ciroque/portal-gun-firmware/adr/README.md

# Architecture decision records

ADRs capture a consequential decision, its reason, and its tradeoffs. Keep each
record short; implementation details belong in code or design documents.

These initial records capture decisions already stated in
[the project handoff](../THE-NEW-HOTNESS.md). They do not represent a completed
architecture proposal or hardware validation.

| ADR | Decision | Status |
| --- | --- | --- |
| [0001](0001-native-esp-idf.md) | Use ESP32-S3 with native ESP-IDF and C++ | Accepted |
| [0002](0002-preserve-existing-behavior.md) | Preserve the sketch's behavior during migration | Accepted |
| [0003](0003-controller-coordinates-subsystems.md) | Coordinate subsystems through a responsive controller | Accepted |
| [0004](0004-persist-settings-in-nvs.md) | Persist validated, versioned settings in NVS | Accepted |
| [0005](0005-removable-battery-and-hardware-power.md) | Use a removable battery and physical power disconnect | Accepted |
| [0006](0006-synchronized-lighting-and-muzzle.md) | Synchronize charge indicators and muzzle with firing phases | Accepted; muzzle portion superseded by 0009 |
| [0007](0007-native-audio-and-standalone-operation.md) | Prefer native audio and keep operation independent of networking | Accepted |
| [0008](0008-gpio-allocation.md) | Allocate GPIOs while preserving programming and debug interfaces | Accepted; board photos checked |
| [0009](0009-defer-muzzle-emitter.md) | Defer muzzle emitter; retain driver selection and deferral details | Accepted |
| [0010](0010-audio-hardware.md) | Use Adafruit #3006 with one Shutao 4 Ω / 3 W speaker | Accepted |
| [0011](0011-power-budget.md) | Budget initial-build power and validate the candidate supply | Proposed |
| [0012](0012-charge-led-timing.md) | Space charge LED transitions across the spin-up duration | Accepted |
| [0013](0013-settings-feedback.md) | Provide nonblocking curve and color feedback with trigger interruption | Accepted |
| [0014](0014-audio-events-and-failed-shots.md) | Map audio events and add a 5% cosmetic failed-shot outcome | Accepted |
| [0015](0015-audio-format-and-storage.md) | Embed mono 44.1 kHz 16-bit PCM WAV playback assets in firmware flash | Accepted |
| [0016](0016-firmware-component-architecture.md) | Separate portable effect logic from ESP-IDF adapters; use controller and audio tasks | Accepted baseline |
| [0017](0017-test-framework-and-tdd.md) | Use doctest for host TDD and Unity for target-specific checks | Accepted |

Use sequential numbers and descriptive filenames. New decisions can start as
**Proposed** and become **Accepted** when agreed. Preserve old records when a
decision changes: mark them **Superseded by ADR-NNNN** and link the replacement.

Still open: overall power budget validation and implementation/bench tuning
identified in ADR-0016. Component boundaries and layout are established there.
