ciroque/portal-gun-firmware/docs/kicad/audio/audio.kicad_sch

## KiCad design docs/kicad/audio/audio.kicad_sch (2026-10-30)

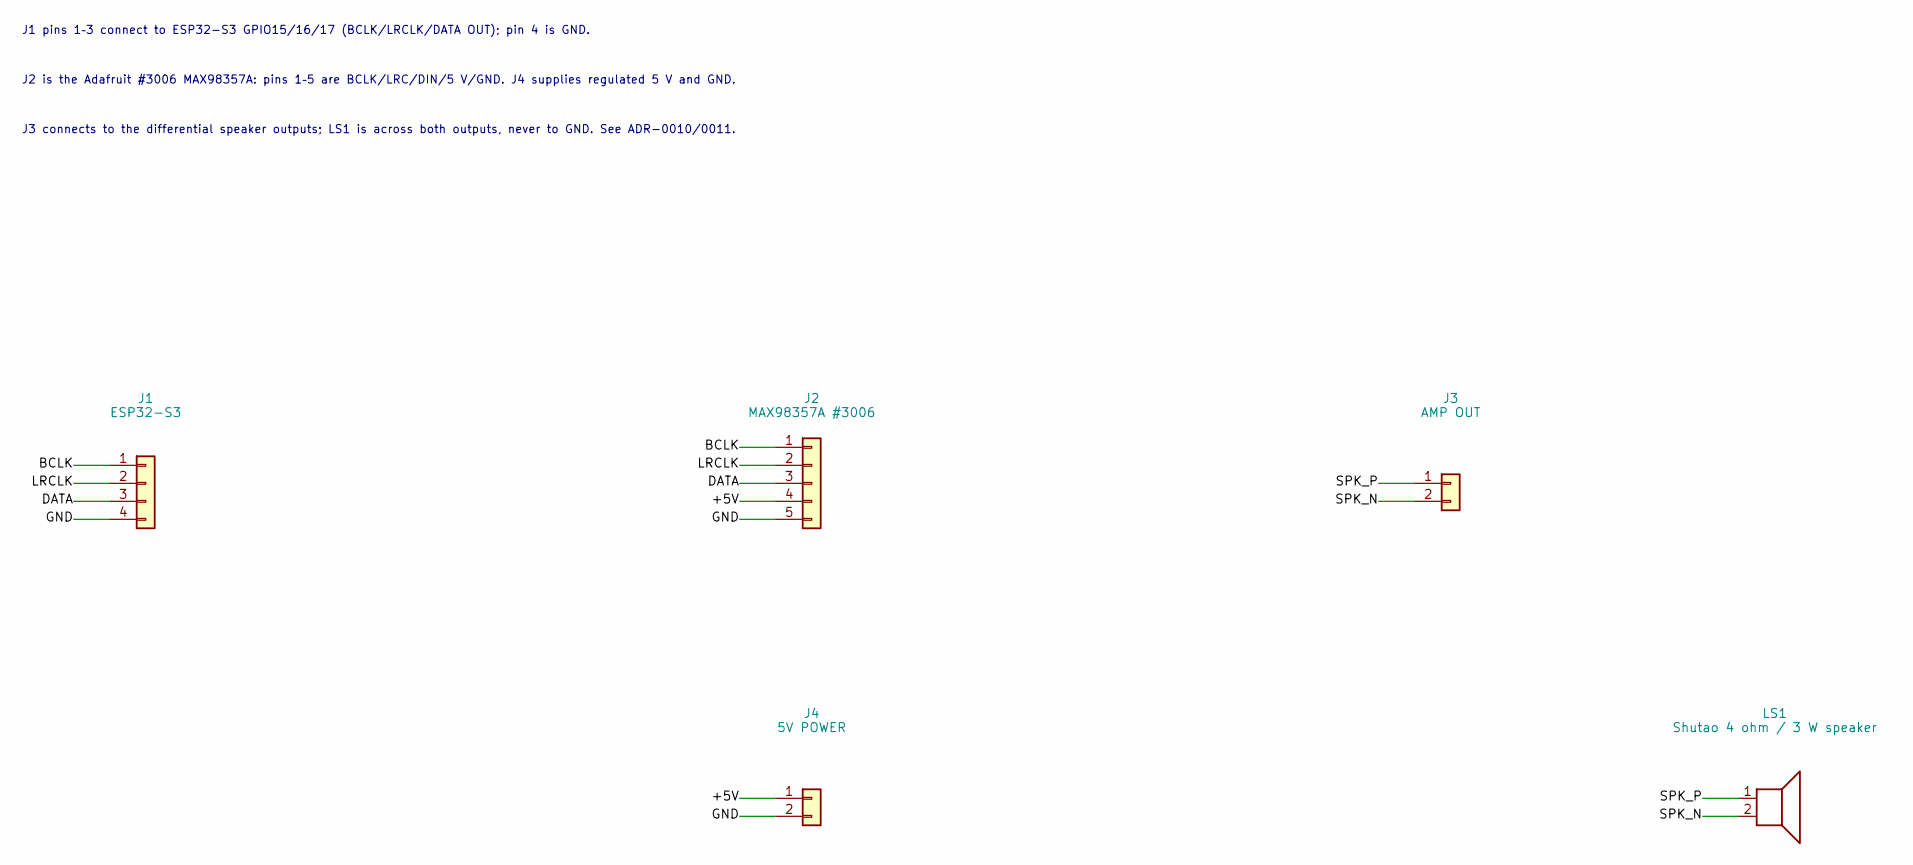
[picture p3: schematic audio.kicad_sch]

Parts:
J1: ESP32-S3
J2: MAX98357A #3006
J3: AMP OUT
J4: 5V POWER
LS1: Shutao 4 ohm / 3 W speaker

Connections:
+5V: J2.4, J4.1
BCLK: J1.1, J2.1
DATA: J1.3, J2.3
GND: J1.4, J2.5, J4.2
LRCLK: J1.2, J2.2
SPK_N: J3.2, LS1.2
SPK_P: J3.1, LS1.1

Notes on the sheet:
J1 pins 1–3 connect to ESP32-S3 GPIO15/16/17 (BCLK/LRCLK/DATA OUT); pin 4 is GND.
J2 is the Adafruit #3006 MAX98357A: pins 1–5 are BCLK/LRC/DIN/5 V/GND. J4 supplies regulated 5 V and GND.
J3 connects to the differential speaker outputs; LS1 is across both outputs, never to GND. See ADR-0010/0011.
