ciroque/portal-gun-firmware/docs/kicad/controls/controls.kicad_sch

## KiCad design docs/kicad/controls/controls.kicad_sch (2026-10-30)

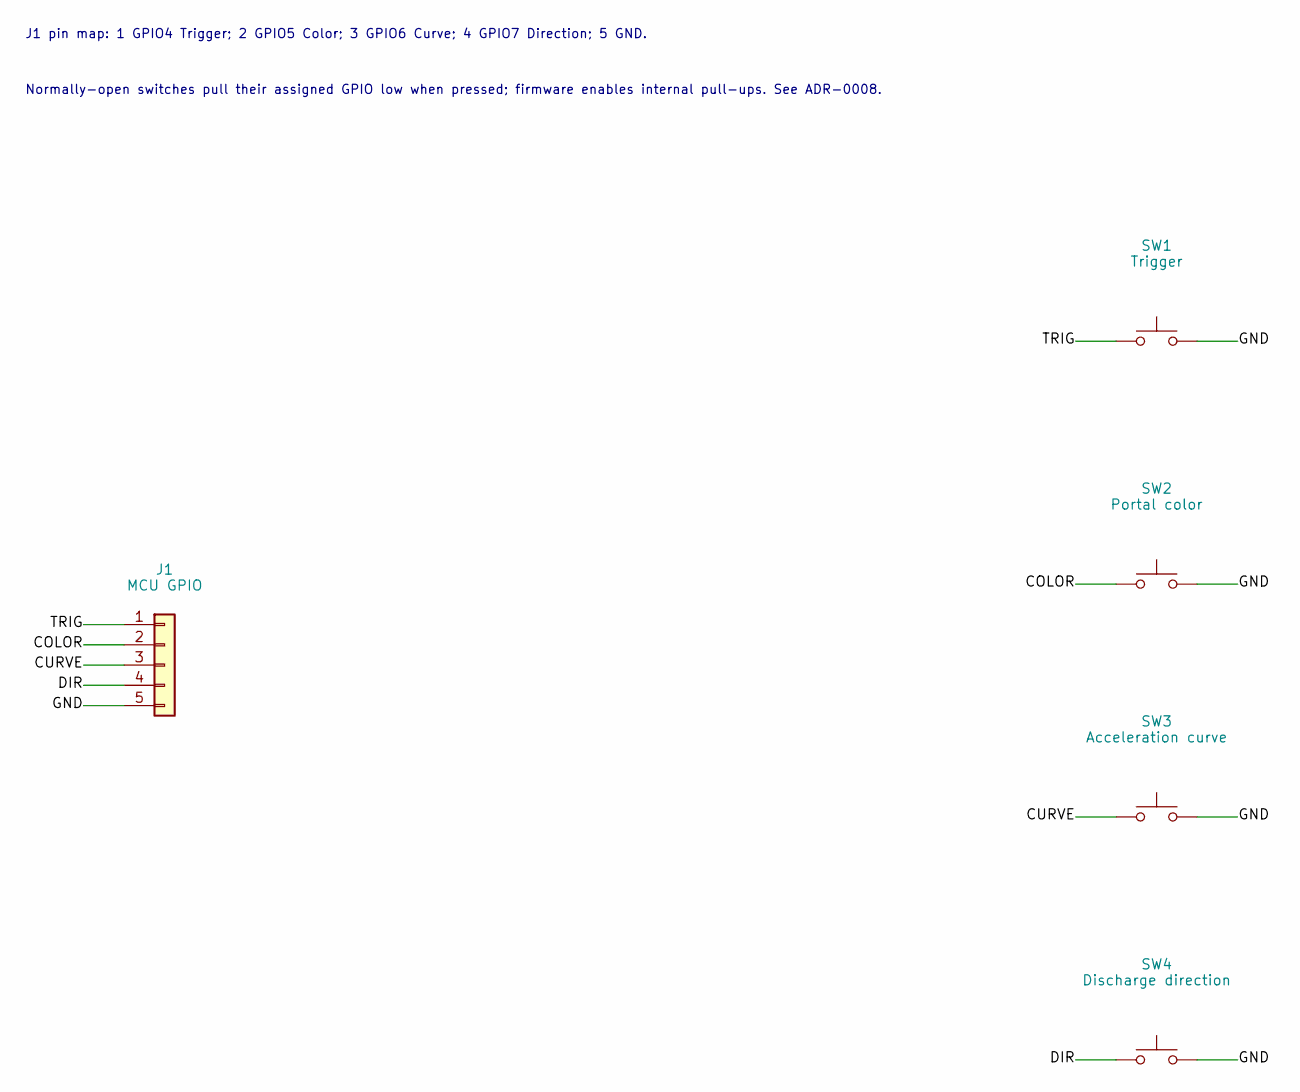
[picture p4: schematic controls.kicad_sch]

Parts:
J1: MCU GPIO
SW1: Trigger
SW2: Portal color
SW3: Acceleration curve
SW4: Discharge direction

Connections:
COLOR: J1.2, SW2.1
CURVE: J1.3, SW3.1
DIR: J1.4, SW4.1
GND: J1.5, SW1.2, SW2.2, SW3.2, SW4.2
TRIG: J1.1, SW1.1

Notes on the sheet:
J1 pin map: 1 GPIO4 Trigger; 2 GPIO5 Color; 3 GPIO6 Curve; 4 GPIO7 Direction; 5 GND.
Normally-open switches pull their assigned GPIO low when pressed; firmware enables internal pull-ups. See ADR-0008.
