ciroque/portal-gun-firmware/docs/kicad/power/power.kicad_sch

## KiCad design docs/kicad/power/power.kicad_sch (2026-10-30)

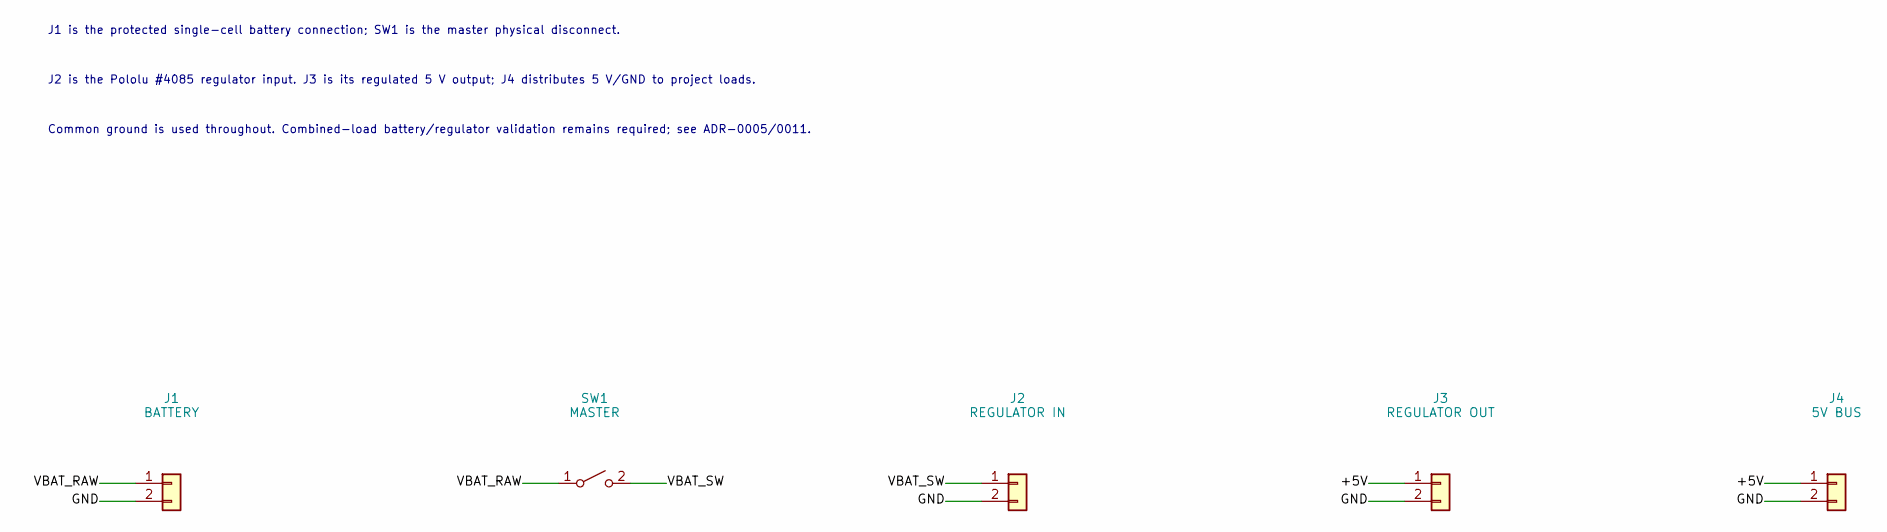
[picture p5: schematic power.kicad_sch]

Parts:
J1: BATTERY
J2: REGULATOR IN
J3: REGULATOR OUT
J4: 5V BUS
SW1: MASTER

Connections:
+5V: J3.1, J4.1
GND: J1.2, J2.2, J3.2, J4.2
VBAT_RAW: J1.1, SW1.1 (A)
VBAT_SW: J2.1, SW1.2 (B)

Notes on the sheet:
J1 is the protected single-cell battery connection; SW1 is the master physical disconnect.
J2 is the Pololu #4085 regulator input. J3 is its regulated 5 V output; J4 distributes 5 V/GND to project loads.
Common ground is used throughout. Combined-load battery/regulator validation remains required; see ADR-0005/0011.
