ciroque/portal-gun-firmware/docs/kicad/ring-lighting/ring-lighting.kicad_sch

## KiCad design docs/kicad/ring-lighting/ring-lighting.kicad_sch (2026-10-30)

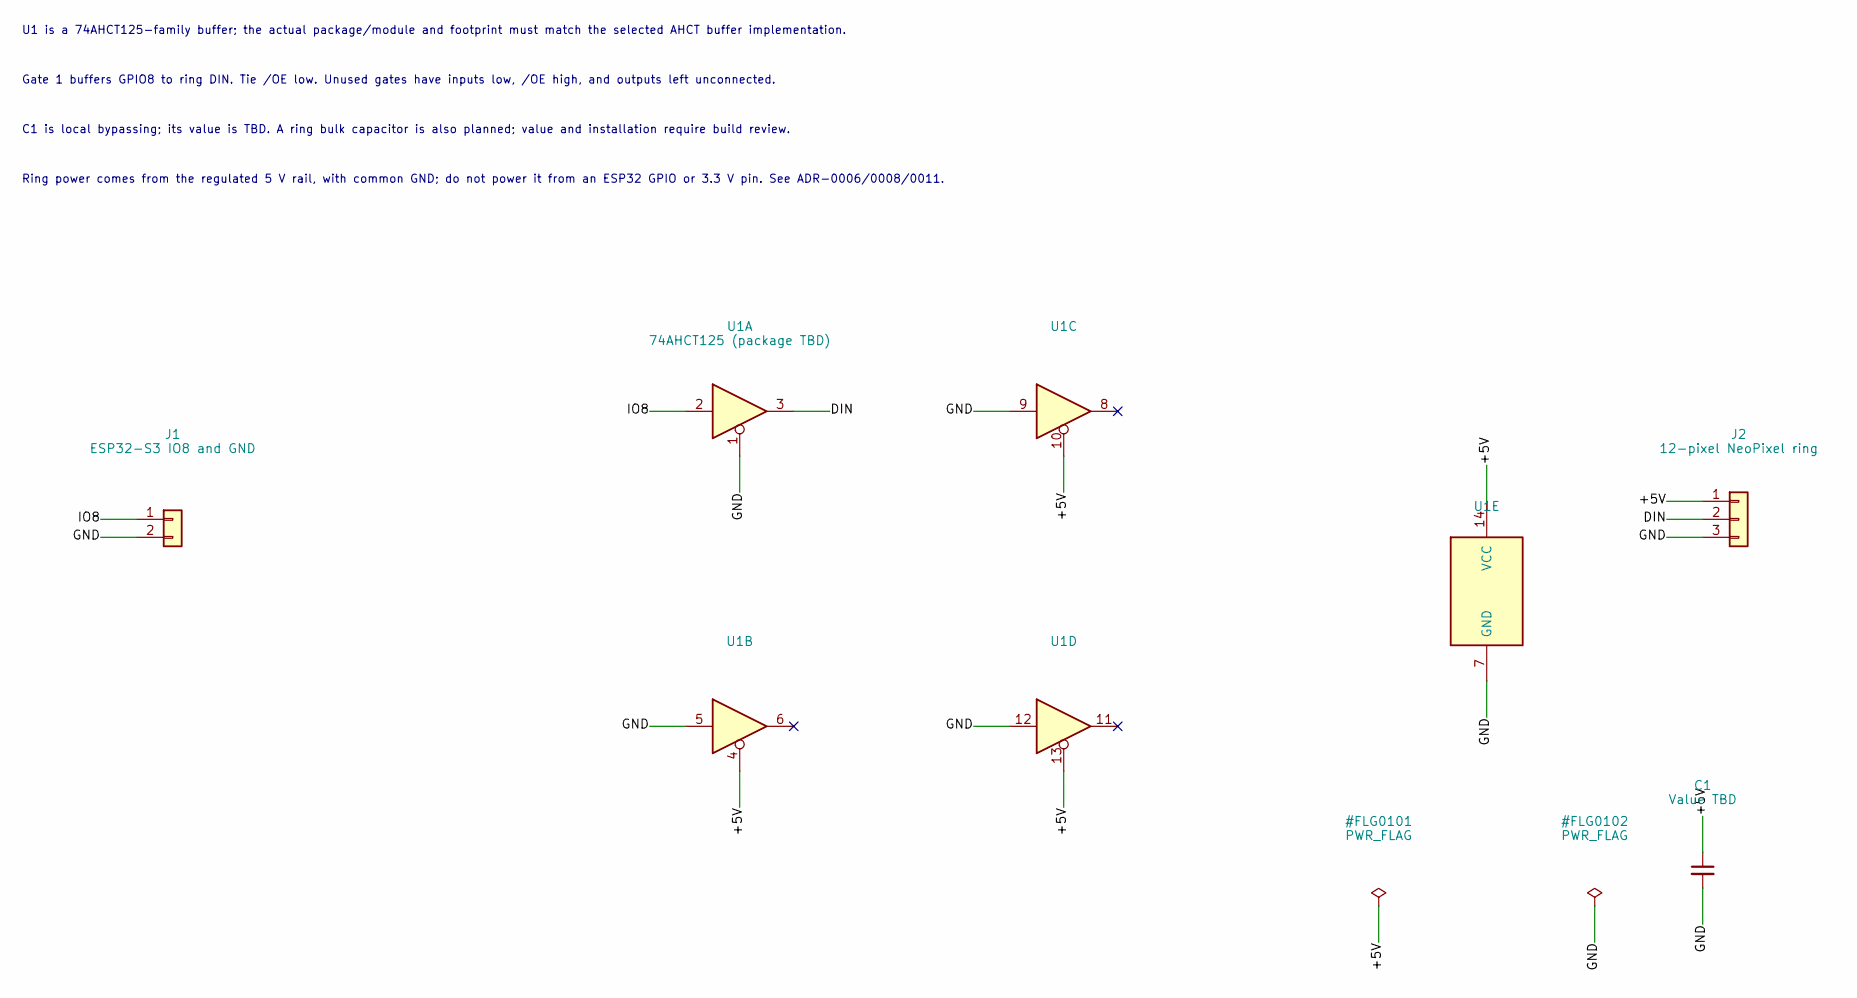
[picture p6: schematic ring-lighting.kicad_sch]

Parts:
C1: Value TBD
J1: ESP32-S3 IO8 and GND
J2: 12-pixel NeoPixel ring
U1: 74AHCT125 (package TBD)

Connections:
+5V: C1.1, J2.1, U1.4, U1.10, U1.13, U1.14 (VCC)
DIN: J2.2, U1.3
GND: C1.2, J1.2, J2.3, U1.1, U1.5, U1.7 (GND), U1.9, U1.12
IO8: J1.1, U1.2

Notes on the sheet:
U1 is a 74AHCT125-family buffer; the actual package/module and footprint must match the selected AHCT buffer implementation.
Gate 1 buffers GPIO8 to ring DIN. Tie /OE low. Unused gates have inputs low, /OE high, and outputs left unconnected.
C1 is local bypassing; its value is TBD. A ring bulk capacitor is also planned; value and installation require build review.
Ring power comes from the regulated 5 V rail, with common GND; do not power it from an ESP32 GPIO or 3.3 V pin. See ADR-0006/0008/0011.
