ciroque/portal-gun-firmware/(commit log)

2026-10-25 ESP32-S3 GPIO Pin Confirmations
2026-10-25 Add power budget ADR
2026-10-25 Add LED Charge Timing ADR
2026-10-26 build(sdk): pin ESP-IDF v6.0.3 and document setup (#1)
    * build(sdk): pin ESP-IDF v6.0.2 and document setup
    * build(sdk): update pin and derive setup commands from version file
    * docs(contributing): separate hosting guidance and correct access status
    * docs(setup): address follow-up review nits
2026-10-26 build(firmware): scaffold ESP32-S3 application and host tests (#3)
    * build(test): vendor doctest v2.4.12 for offline host tests
    * build(firmware): scaffold ESP32-S3 app and host test harness
    * fix(build): verify SDK on every build and honor board defaults
    * fix(test): lock board wiring and align C++17 compiler settings
    * test(build): match firmware SDK validation order
    [partitions.csv]
2026-10-26 ci(test): run host suites on pull requests and main (#4)
    * ci(test): run host suites on pull requests and main
    * ci(test): preserve main runs and tighten host checks
2026-10-26 feat: implement portal runtime with hardware and audio (#5)
    * feat(core): migrate prop effects and controller with reference tests
    * feat(hardware): connect ring inputs charge indicators and NVS settings
    * feat(audio): integrate PCM playback and complete prop runtime
    * fix: address runtime PR feedback
    [audio.cpp, controller.cpp, core_test.cpp]
2026-10-30 docs: add hardware connection pin map
2026-10-30 docs: add KiCad subsystem wiring maps
    [audio.kicad_sch, charge-indicators.kicad_sch, controls.kicad_sch, muzzle-deferred.kicad_sch, power.kicad_sch, ring-lighting.kicad_sch]
2026-10-30 docs: remove hardware procurement status
    [audio.kicad_sch, muzzle-deferred.kicad_sch]
2026-10-30 docs: generate KiCad subsystem schematics
    [audio.kicad_sch, charge-indicators.kicad_sch, controls.kicad_sch, muzzle-deferred.kicad_sch, power.kicad_sch, ring-lighting.kicad_sch]
