ciroque/portal-gun-firmware/docs/ESP32-S3-top.JPG

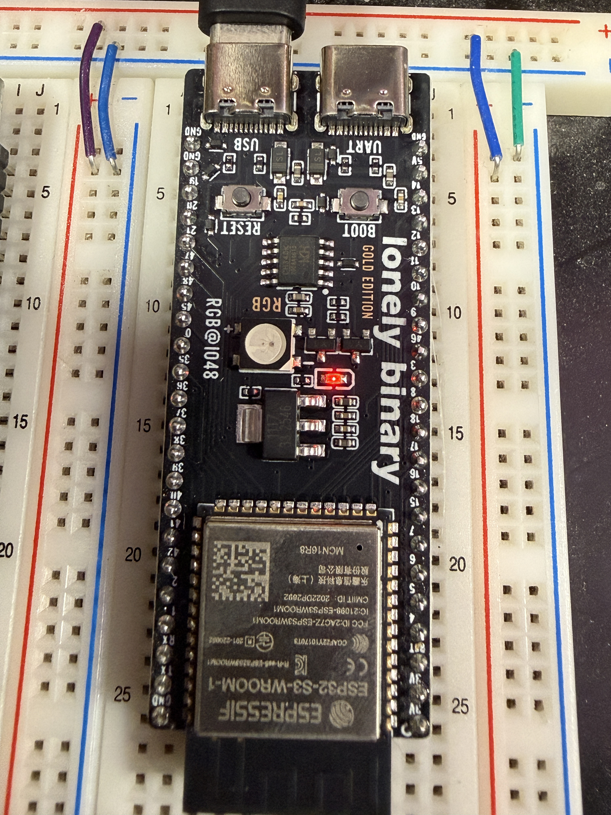
[picture p1: docs/ESP32-S3-top.JPG]
docs/ESP32-S3-top.JPG
