ciroque/portal-gun-firmware/docs/ESP32-S3-bottom.JPG

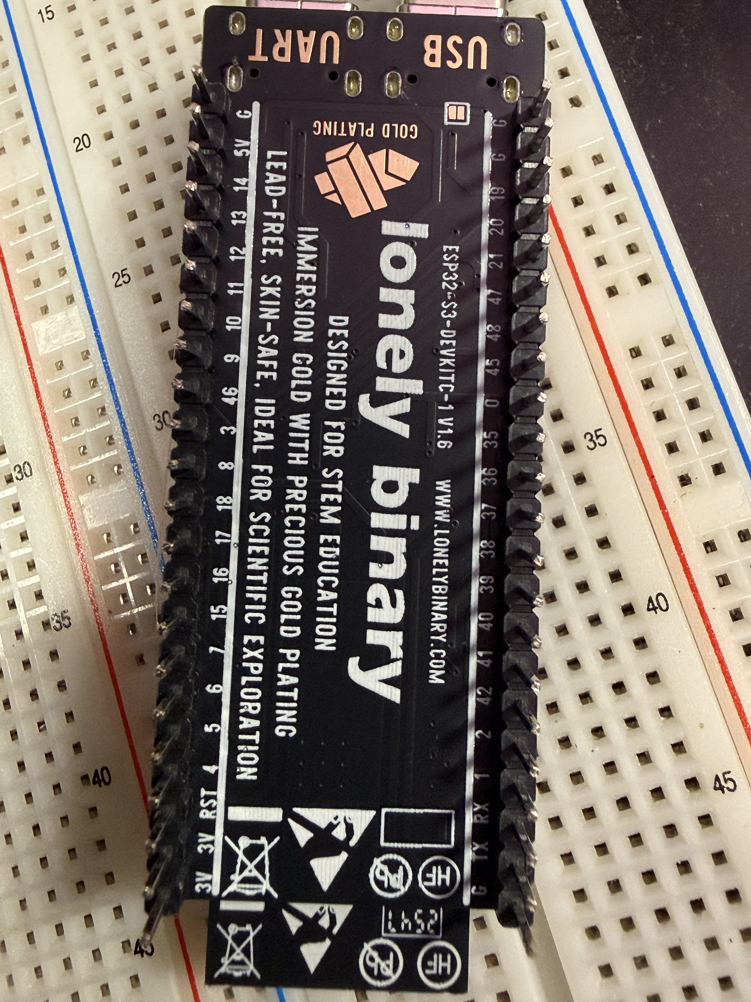
[picture p2: docs/ESP32-S3-bottom.JPG]
docs/ESP32-S3-bottom.JPG
